jnedbal/garduino_1_0/guarduino.kicad_pcb

## KiCad design guarduino.kicad_pcb (2016-11-27)

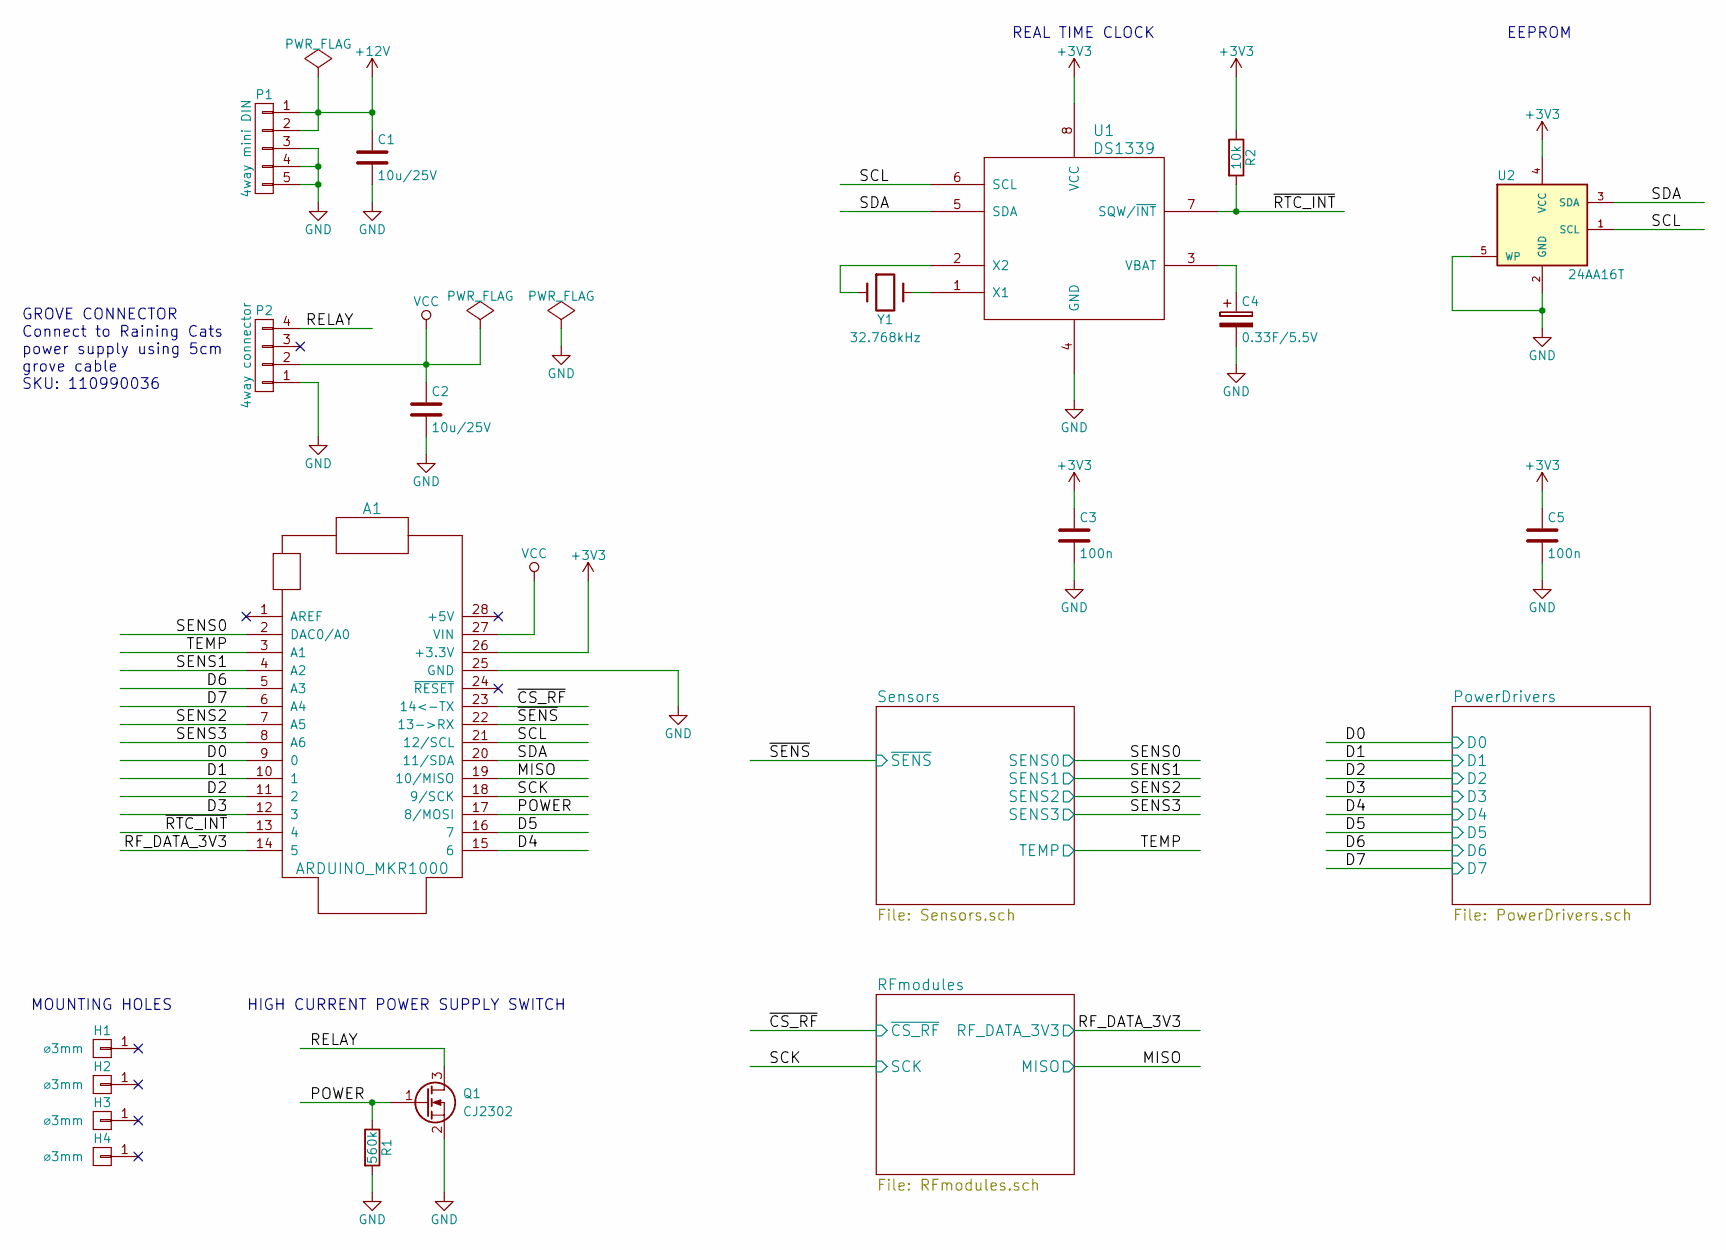
[picture p1: schematic guarduino.sch, Guarduino Control Unit]

Parts:
A1: ARDUINO_MKR1000
C1, C2: 10u/25V; C_0805; Part Number CC0805KKX5R8BB106
C3, C5: 100n; C_0603; Part Number CC0603KRX7R9BB104
C4: 0.33F/5.5V; SD_CAP; Part Number EECS0HD334VN
H1, H2, H3, H4: ⌀3mm; MountingHole_3.2mm_M3
P1: 4way mini DIN; MiniDIN4way; Part Number 2MJ-0402A110
P2: 4way connector; JST_PH_04way_vert; Part Number 1125S-4P
Q1: CJ2302; SOT-23; Part Number CJ2302
R1: 560k; R_0603; Part Number RC0603JR-07560KL
R2: 10k; R_0603; Part Number RC0603FR-0710KL
U1: DS1339; MSOP-8_3x3mm_Pitch0.65mm; Part Number DS1339U-33+T&R
U2: 24AA16T; SOT-23-5; Part Number 24AA16T-I/OT
Y1: 32.768kHz; Crystal_SMD_5032_2Pads; Part Number FC-135

Connections:
+3V3: A1.26 (+3.3V), C3.1, C5.1, R2.1, U1.8 (VCC), U2.4 (VCC); also elsewhere on the board
+12V: C1.1, P1.1, P1.2; also elsewhere on the board
/POWER: A1.17 (8/MOSI), Q1.1 (G), R1.1
/PowerDrivers/D0: A1.9 (0); also elsewhere on the board
/PowerDrivers/D1: A1.10 (1); also elsewhere on the board
/PowerDrivers/D2: A1.11 (2); also elsewhere on the board
/PowerDrivers/D3: A1.12 (3); also elsewhere on the board
/PowerDrivers/D4: A1.15 (6); also elsewhere on the board
/PowerDrivers/D5: A1.16 (7); also elsewhere on the board
/PowerDrivers/D6: A1.5 (A3); also elsewhere on the board
/PowerDrivers/D7: A1.6 (A4); also elsewhere on the board
/RELAY: P2.4, Q1.3 (D)
/RFmodules/MISO: A1.19 (10/MISO); also elsewhere on the board
/RFmodules/RF_DATA_3V3: A1.14 (5); also elsewhere on the board
/RFmodules/SCK: A1.18 (9/SCK); also elsewhere on the board
/RFmodules/~CS_RF: A1.23 (14<-TX); also elsewhere on the board
/SCL: A1.21 (12/SCL), U1.6 (SCL), U2.1 (SCL)
/SDA: A1.20 (11/SDA), U1.5 (SDA), U2.3 (SDA)
/Sensors/SENS0: A1.2 (DAC0/A0); also elsewhere on the board
/Sensors/SENS1: A1.4 (A2); also elsewhere on the board
/Sensors/SENS2: A1.7 (A5); also elsewhere on the board
/Sensors/SENS3: A1.8 (A6); also elsewhere on the board
/Sensors/TEMP: A1.3 (A1); also elsewhere on the board
/Sensors/~SENS: A1.22 (13->RX); also elsewhere on the board
/~RTC_INT: A1.13 (4), R2.2, U1.7 (SQW/~INT)
GND: A1.25 (GND), C1.2, C2.2, C3.2, C4.2, C5.2, P1.3, P1.4, P1.5, P2.1, Q1.2 (S), R1.2, U1.4 (GND), U2.2 (GND), U2.5 (WP); also elsewhere on the board
unnamed: C4.1, U1.3 (VBAT)
unnamed: U1.1 (X1), Y1.2
unnamed: U1.2 (X2), Y1.1
VCC: A1.27 (VIN), C2.1, P2.2; also elsewhere on the board

Notes on the sheet:
GROVE CONNECTOR Connect to Raining Cats power supply using 5cm grove cable SKU: 110990036
REAL TIME CLOCK
EEPROM
MOUNTING HOLES
HIGH CURRENT POWER SUPPLY SWITCH

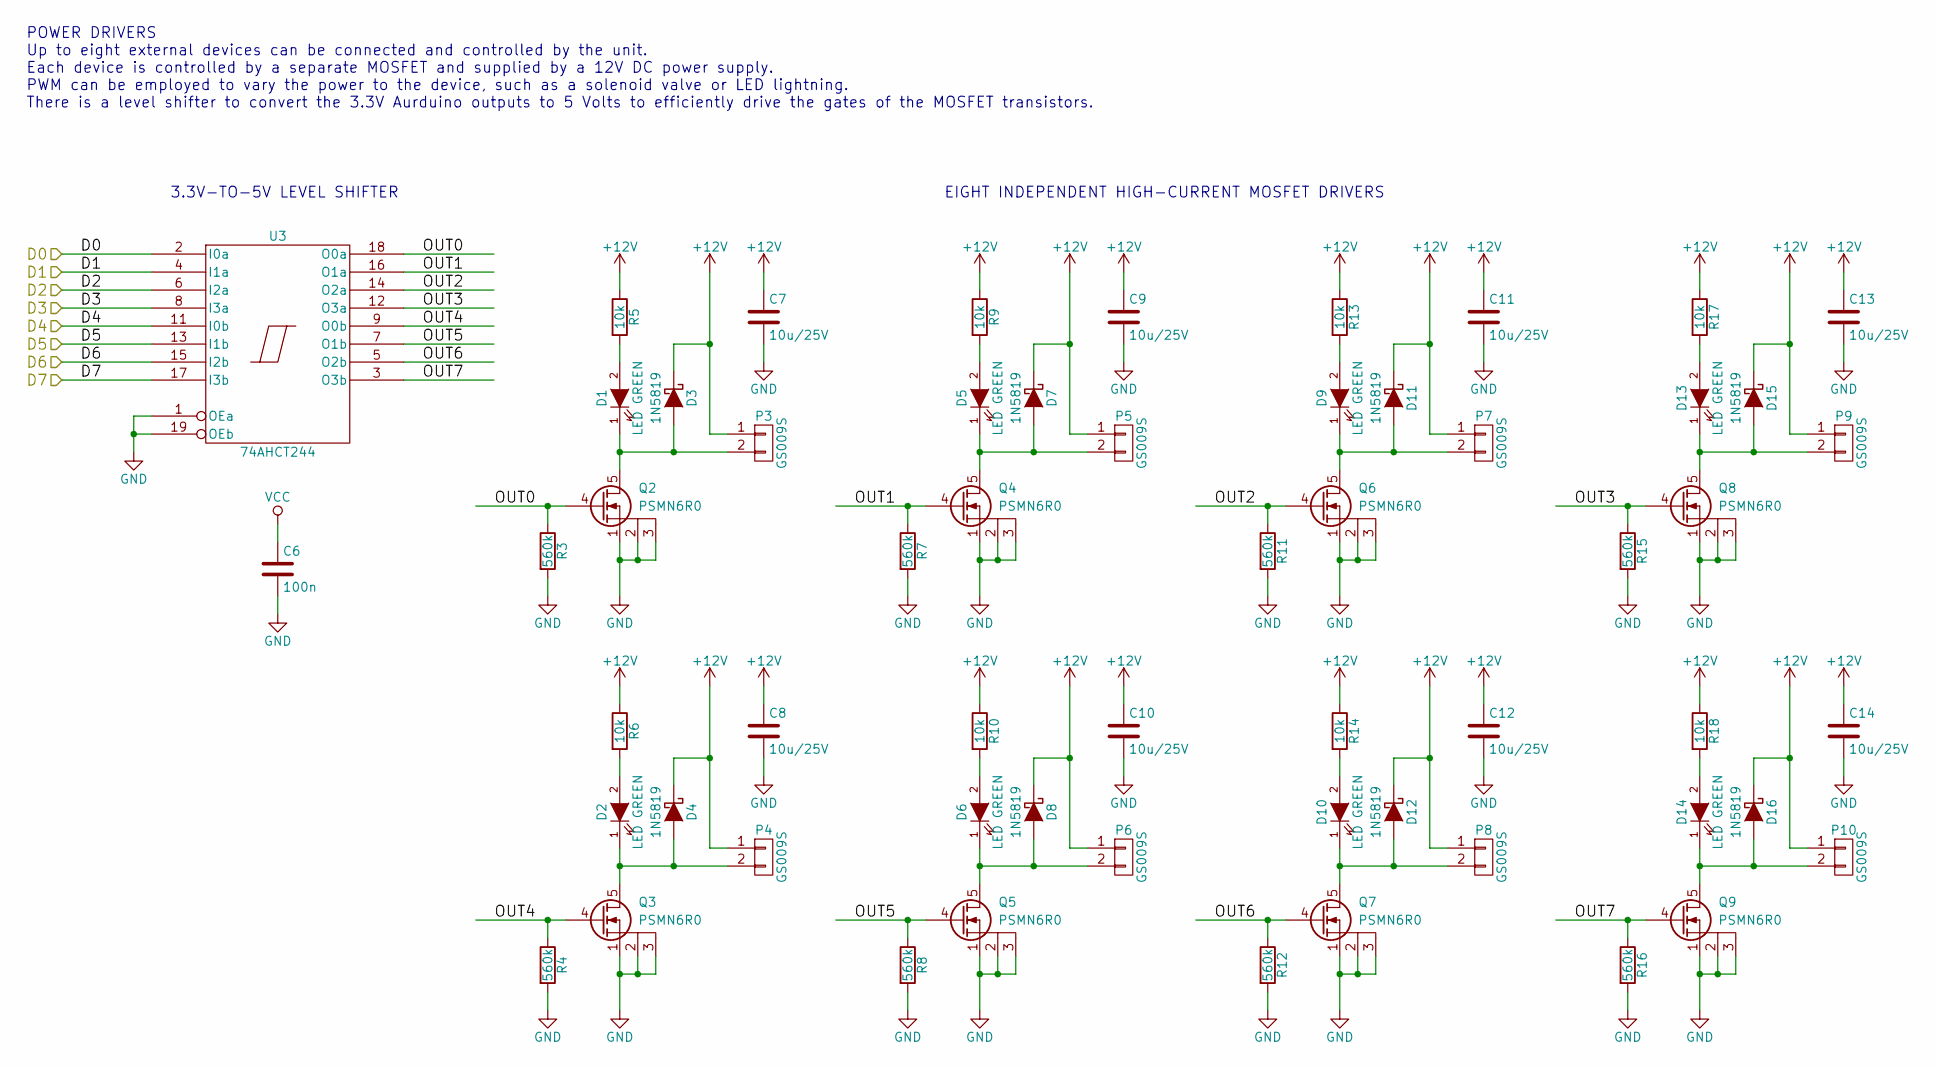
[picture p2: schematic PowerDrivers.sch, Guarduino Control Unit]

Parts:
C6: 100n; C_0603; Part Number CC0603KRX7R9BB104
C7, C8, C9, C10, C11, C12, C13, C14: 10u/25V; C_0805; Part Number CC0805KKX5R8BB106
D1, D2, D5, D6, D9, D10, D13, D14: LED GREEN; LED_0603; Part Number 19-217-G7C-AN1P2-3T
D3, D4, D7, D8, D11, D12, D15, D16: 1N5819; SMA_Standard; Part Number 1N5819HW-7-F
P3, P4, P5, P6, P7, P8, P9, P10: GS009S; AK300-2; Part Number GS009S-5.0-02P-1
Q2, Q3, Q4, Q5, Q6, Q7, Q8, Q9: PSMN6R0; SO-8_PowerPAK_Vishay_Single; Part Number PSMN6R0-30YLB
R3, R4, R7, R8, R11, R12, R15, R16: 560k; R_0603; Part Number RC0603JR-07560KL
R5, R6, R9, R10, R13, R14, R17, R18: 10k; R_0603; Part Number RC0603FR-0710KL
U3: 74AHCT244; TSSOP-20_4.4x6.5mm_Pitch0.65mm; Part Number SN74AHCT244PW

Connections:
+12V: C7.1, C8.1, C9.1, C10.1, C11.1, C12.1, C13.1, C14.1, D3.1 (K), D4.1 (K), D7.1 (K), D8.1 (K), D11.1 (K), D12.1 (K), D15.1 (K), D16.1 (K), P3.1, P4.1, P5.1, P6.1, P7.1, P8.1, P9.1, P10.1, R5.1, R6.1, R9.1, R10.1, R13.1, R14.1, R17.1, R18.1; also elsewhere on the board
/PowerDrivers/D0: U3.2 (I0a); also elsewhere on the board
/PowerDrivers/D1: U3.4 (I1a); also elsewhere on the board
/PowerDrivers/D2: U3.6 (I2a); also elsewhere on the board
/PowerDrivers/D3: U3.8 (I3a); also elsewhere on the board
/PowerDrivers/D4: U3.11 (I0b); also elsewhere on the board
/PowerDrivers/D5: U3.13 (I1b); also elsewhere on the board
/PowerDrivers/D6: U3.15 (I2b); also elsewhere on the board
/PowerDrivers/D7: U3.17 (I3b); also elsewhere on the board
/PowerDrivers/OUT0: Q2.4 (G), R3.1, U3.18 (O0a)
/PowerDrivers/OUT1: Q4.4 (G), R7.1, U3.16 (O1a)
/PowerDrivers/OUT2: Q6.4 (G), R11.1, U3.14 (O2a)
/PowerDrivers/OUT3: Q8.4 (G), R15.1, U3.12 (O3a)
/PowerDrivers/OUT4: Q3.4 (G), R4.1, U3.9 (O0b)
/PowerDrivers/OUT5: Q5.4 (G), R8.1, U3.7 (O1b)
/PowerDrivers/OUT6: Q7.4 (G), R12.1, U3.5 (O2b)
/PowerDrivers/OUT7: Q9.4 (G), R16.1, U3.3 (O3b)
GND: C6.2, C7.2, C8.2, C9.2, C10.2, C11.2, C12.2, C13.2, C14.2, Q2.1 (S), Q2.2 (S), Q2.3 (S), Q3.1 (S), Q3.2 (S), Q3.3 (S), Q4.1 (S), Q4.2 (S), Q4.3 (S), Q5.1 (S), Q5.2 (S), Q5.3 (S), Q6.1 (S), Q6.2 (S), Q6.3 (S), Q7.1 (S), Q7.2 (S), Q7.3 (S), Q8.1 (S), Q8.2 (S), Q8.3 (S), Q9.1 (S), Q9.2 (S), Q9.3 (S), R3.2, R4.2, R7.2, R8.2, R11.2, R12.2, R15.2, R16.2, U3.1 (OEa), U3.10 (GND), U3.19 (OEb); also elsewhere on the board
unnamed: D1.1 (K), D3.2 (A), P3.2, Q2.5 (D)
unnamed: D1.2 (A), R5.2
unnamed: D2.1 (K), D4.2 (A), P4.2, Q3.5 (D)
unnamed: D2.2 (A), R6.2
unnamed: D5.1 (K), D7.2 (A), P5.2, Q4.5 (D)
unnamed: D5.2 (A), R9.2
unnamed: D6.1 (K), D8.2 (A), P6.2, Q5.5 (D)
unnamed: D6.2 (A), R10.2
unnamed: D9.2 (A), R13.2
unnamed: D10.1 (K), D12.2 (A), P8.2, Q7.5 (D)
unnamed: D10.2 (A), R14.2
unnamed: D9.1 (K), D11.2 (A), P7.2, Q6.5 (D)
unnamed: D13.1 (K), D15.2 (A), P9.2, Q8.5 (D)
unnamed: D13.2 (A), R17.2
unnamed: D14.1 (K), D16.2 (A), P10.2, Q9.5 (D)
unnamed: D14.2 (A), R18.2
VCC: C6.1, U3.20 (VCC); also elsewhere on the board

Notes on the sheet:
POWER DRIVERS Up to eight external devices can be connected and controlled by the unit. Each device is controlled by a separate MOSFET and supplied by a 12V DC power supply. PWM can be employed to vary the power to the device, such as a solenoid valve or LED lightning. There is a level shifter to c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
EIGHT INDEPENDENT HIGH-CURRENT MOSFET DRIVERS
3.3V-TO-5V LEVEL SHIFTER

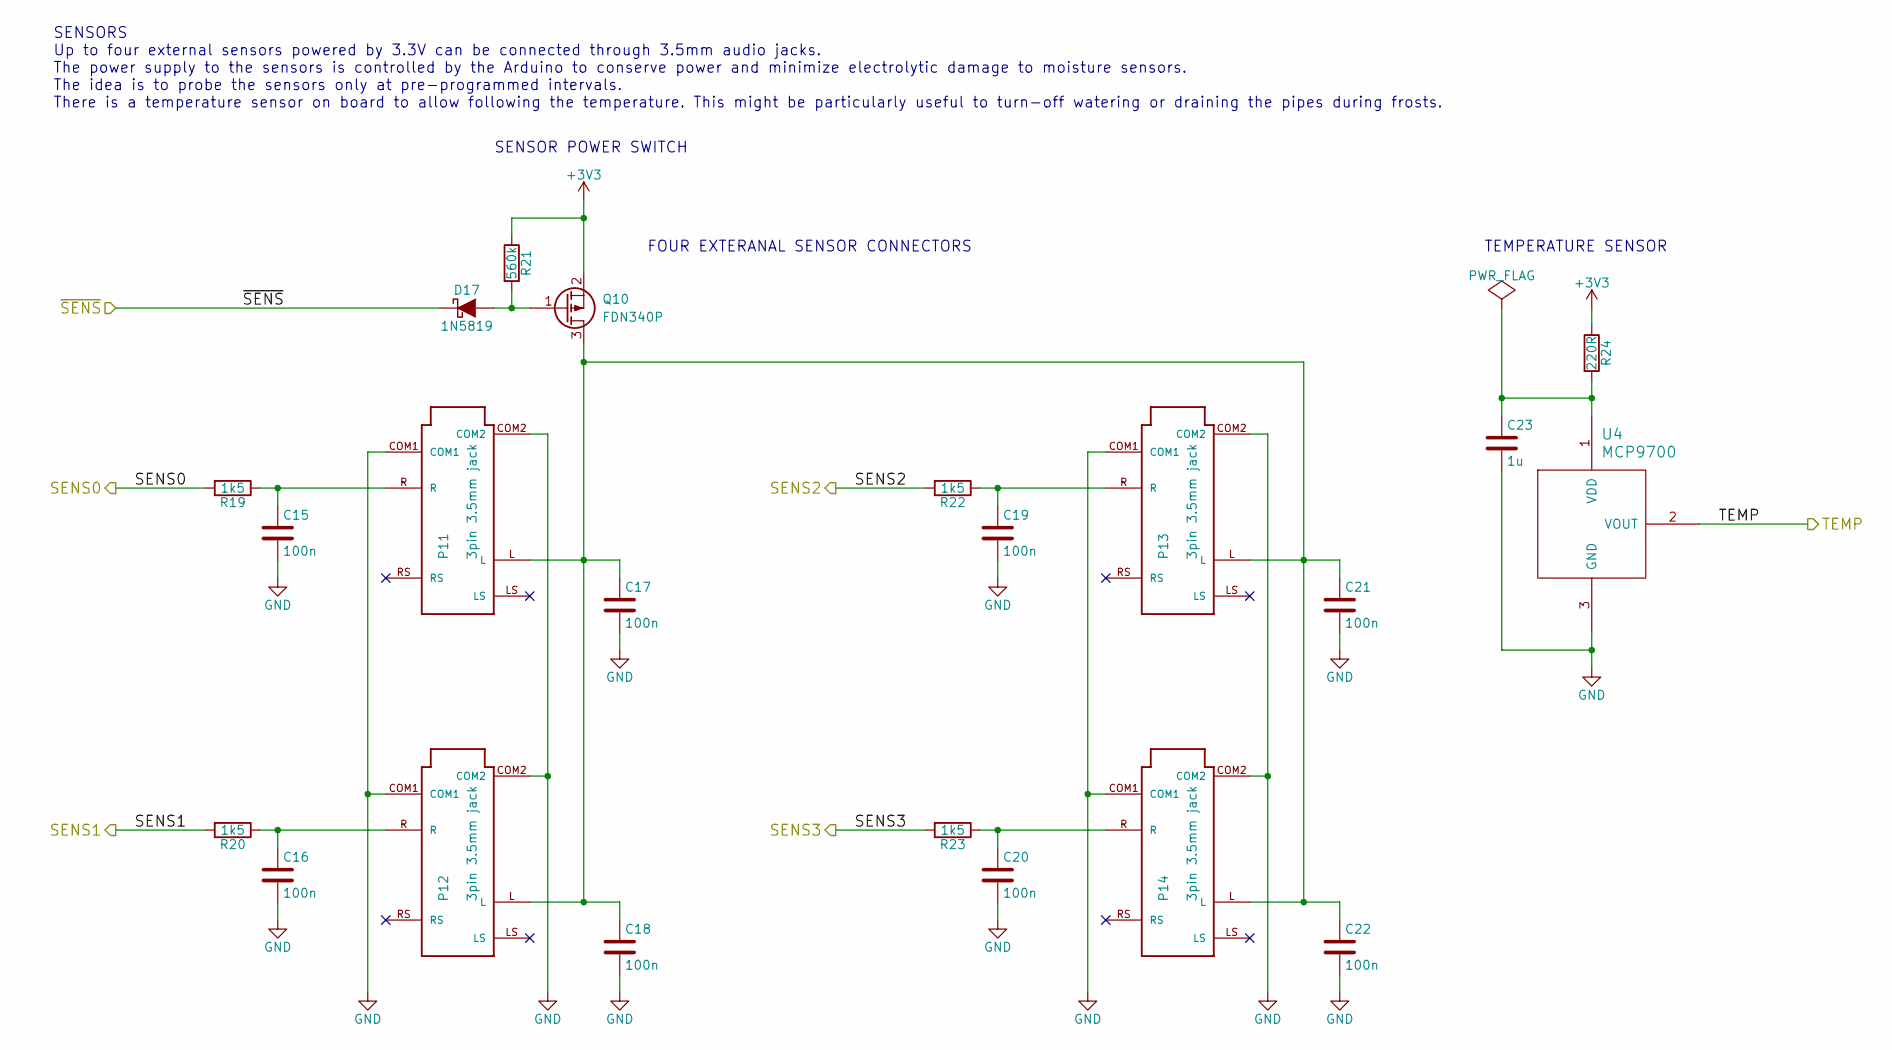
[picture p3: schematic Sensors.sch, Guarduino Control Unit]

Parts:
C15, C16, C17, C18, C19, C20, C21, C22: 100n; C_0603; Part Number CC0603KRX7R9BB104
C23: 1u; C_0603; Part Number CC0603KRX7R8BB105
D17: 1N5819; SMA_Standard; Part Number 1N5819HW-7-F
P11, P12, P13, P14: 3pin 3.5mm jack; SUNTECH_ST-PJ-312; Part Number ST-PJ-312
Q10: FDN340P; SOT-23; Part Number FDN340P
R19, R20, R22, R23: 1k5; R_0603; Part Number RC0603JR-071K5L
R21: 560k; R_0603; Part Number RC0603JR-07560KL
R24: 220R; R_0603; Part Number RC0603JR-07220RL
U4: MCP9700; SOT-23; Part Number MCP9700AT-E/TT

Connections:
+3V3: Q10.2 (S), R21.1, R24.1; also elsewhere on the board
/Sensors/SENS0: R19.2; also elsewhere on the board
/Sensors/SENS1: R20.2; also elsewhere on the board
/Sensors/SENS2: R22.2; also elsewhere on the board
/Sensors/SENS3: R23.2; also elsewhere on the board
/Sensors/TEMP: U4.2 (VOUT); also elsewhere on the board
/Sensors/~SENS: D17.1 (K); also elsewhere on the board
GND: C15.2, C16.2, C17.2, C18.2, C19.2, C20.2, C21.2, C22.2, C23.2, P11.COM1, P11.COM2, P12.COM1, P12.COM2, P13.COM1, P13.COM2, P14.COM1, P14.COM2, U4.3 (GND); also elsewhere on the board
unnamed: C15.1, P11.R, R19.1
unnamed: C16.1, P12.R, R20.1
unnamed: C17.1, C18.1, C21.1, C22.1, P11.L, P12.L, P13.L, P14.L, Q10.3 (D)
unnamed: C19.1, P13.R, R22.1
unnamed: C20.1, P14.R, R23.1
unnamed: C23.1, R24.2, U4.1 (VDD)
unnamed: D17.2 (A), Q10.1 (G), R21.2

Notes on the sheet:
SENSORS Up to four external sensors powered by 3.3V can be connected through 3.5mm audio jacks. The power supply to the sensors is controlled by the Arduino to conserve power and minimize electrolytic damage to moisture sensors. The idea is to probe the sensors only at pre-programmed intervals. The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
SENSOR POWER SWITCH
FOUR EXTERANAL SENSOR CONNECTORS
TEMPERATURE SENSOR

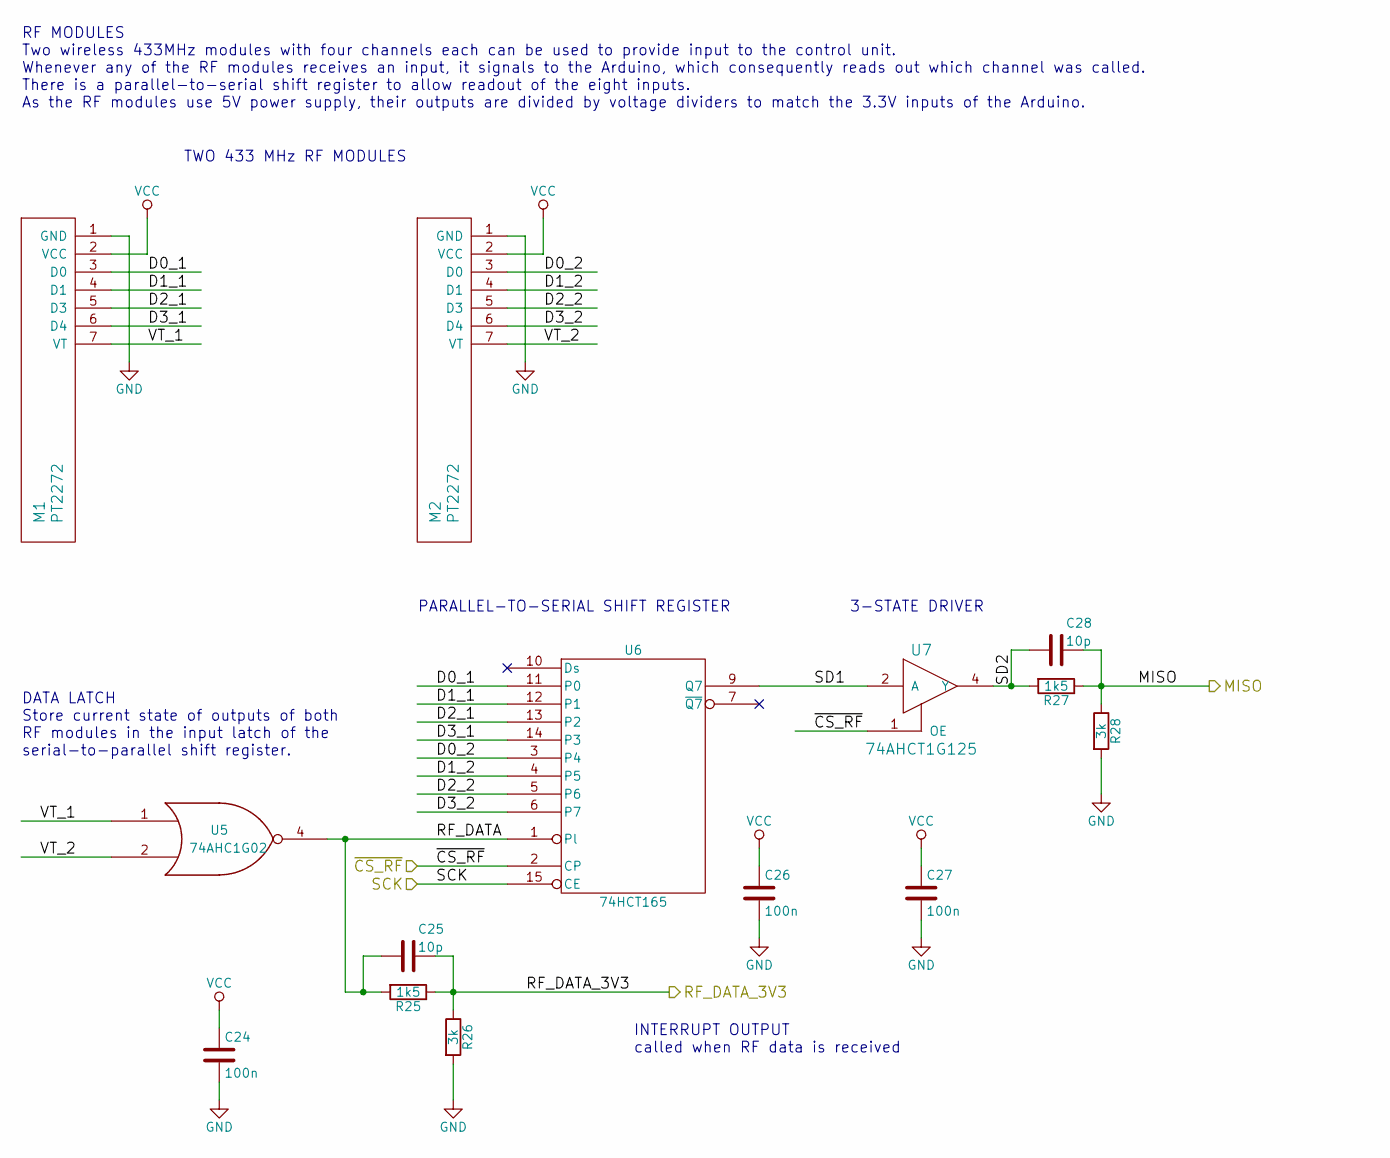
[picture p4: schematic RFmodules.sch, Guarduino Control Unit]

Parts:
C24, C26, C27: 100n; C_0603; Part Number CC0603KRX7R9BB104
C25, C28: 10p; C_0603; Part Number CC0603JRNPO9BN100
M1, M2: PT2272; Socket_Strip_Straight_1x07
R25, R27: 1k5; R_0603; Part Number RC0603JR-071K5L
R26, R28: 3k; R_0603; Part Number RC0603FR-073KL
U5: 74AHC1G02; SC-70-5; Part Number SN74AHC1G02DCKR
U6: 74HCT165; SOIC-16_3.9x9.9mm_Pitch1.27mm; Part Number CD74HCT165M96
U7: 74AHCT1G125; SC-70-5; Part Number SN74AHCT1G125DCKT

Connections:
/RFmodules/D0_1: M1.3 (D0), U6.11 (P0)
/RFmodules/D0_2: M2.3 (D0), U6.3 (P4)
/RFmodules/D1_1: M1.4 (D1), U6.12 (P1)
/RFmodules/D1_2: M2.4 (D1), U6.4 (P5)
/RFmodules/D2_1: M1.5 (D3), U6.13 (P2)
/RFmodules/D2_2: M2.5 (D3), U6.5 (P6)
/RFmodules/D3_1: M1.6 (D4), U6.14 (P3)
/RFmodules/D3_2: M2.6 (D4), U6.6 (P7)
/RFmodules/MISO: C28.1, R27.1, R28.1; also elsewhere on the board
/RFmodules/RF_DATA: C25.2, R25.2, U5.4, U6.1 (Pl)
/RFmodules/RF_DATA_3V3: C25.1, R25.1, R26.1; also elsewhere on the board
/RFmodules/SCK: U6.15 (CE); also elsewhere on the board
/RFmodules/SD1: U6.9 (Q7), U7.2 (A)
/RFmodules/SD2: C28.2, R27.2, U7.4 (Y)
/RFmodules/VT_1: M1.7 (VT), U5.1
/RFmodules/VT_2: M2.7 (VT), U5.2
/RFmodules/~CS_RF: U6.2 (CP), U7.1 (OE); also elsewhere on the board
GND: C24.2, C26.2, C27.2, M1.1 (GND), M2.1 (GND), R26.2, R28.2, U5.3 (GND), U6.8 (GND), U7.3 (GND); also elsewhere on the board
VCC: C24.1, C26.1, C27.1, M1.2 (VCC), M2.2 (VCC), U5.5 (VCC), U6.16 (VCC), U7.5 (VCC); also elsewhere on the board

Notes on the sheet:
RF MODULES Two wireless 433MHz modules with four channels each can be used to provide input to the control unit. Whenever any of the RF modules receives an input, it signals to the Arduino, which consequently reads out which channel was called. There is a parallel-to-serial shift register to allow 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
TWO 433 MHz RF MODULES
DATA LATCH Store current state of outputs of both RF modules in the input latch of the serial-to-parallel shift register.
PARALLEL-TO-SERIAL SHIFT REGISTER
INTERRUPT OUTPUT called when RF data is received
3-STATE DRIVER

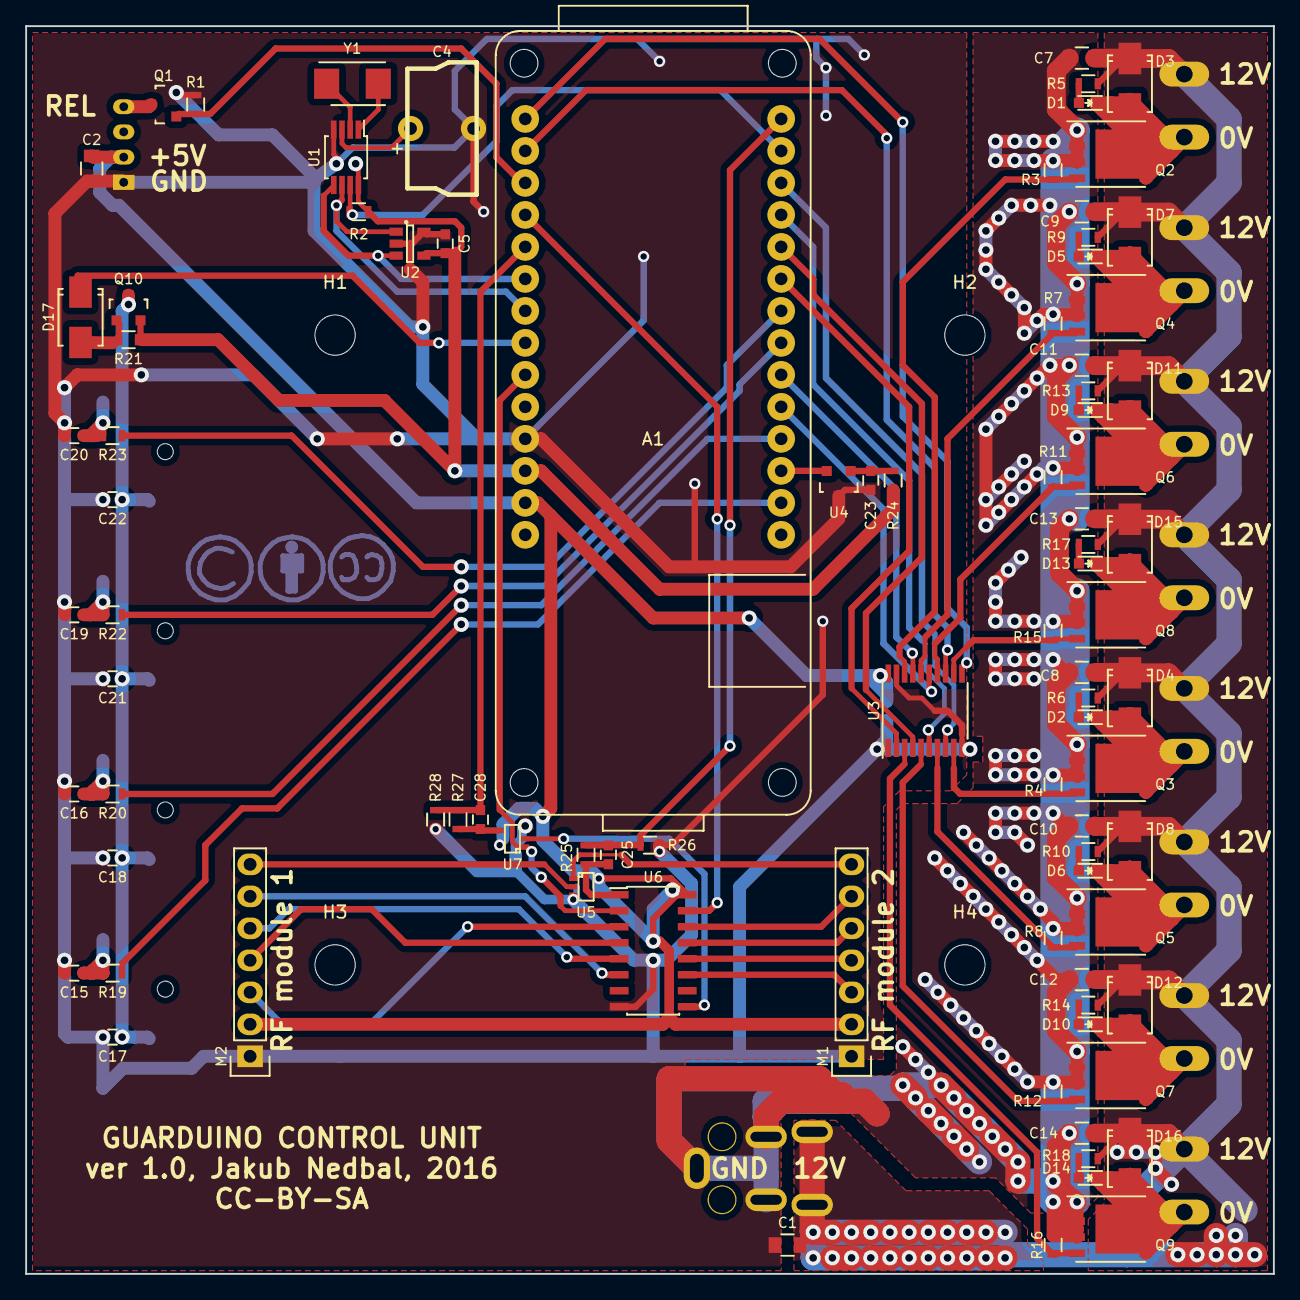
[picture p5: board guarduino.kicad_pcb from above]

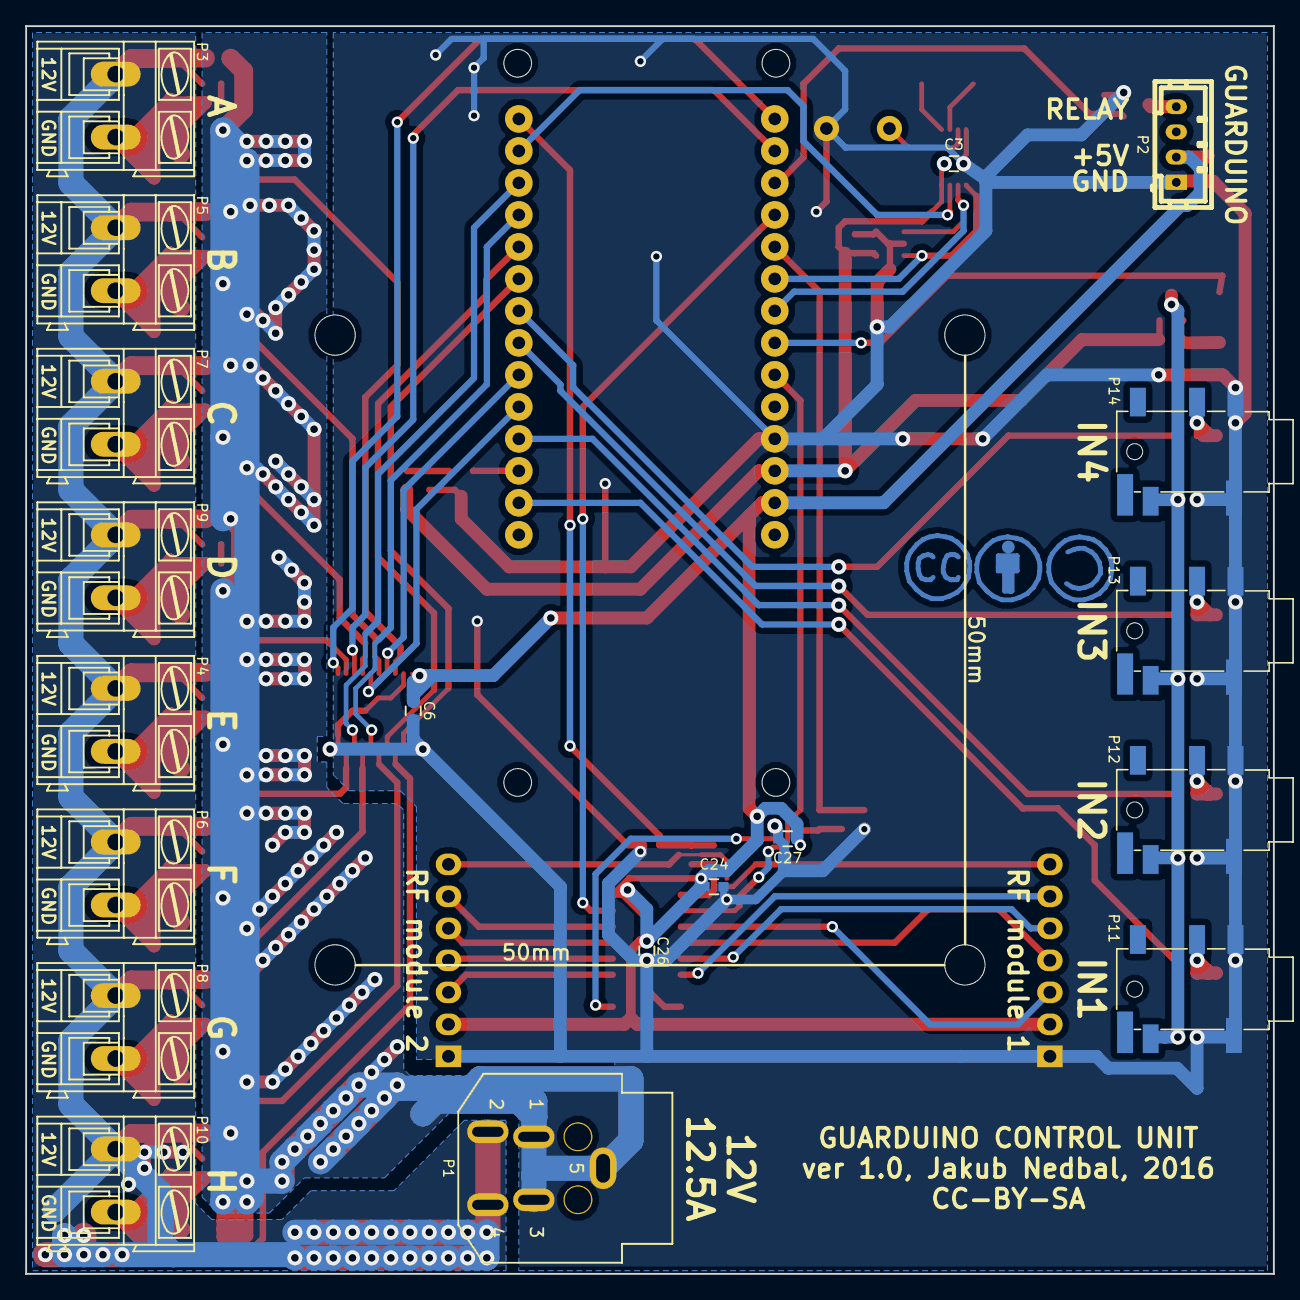
[picture p6: board guarduino.kicad_pcb from below]

Board: 2 copper layers, 99.1 x 99.1 mm, 112 parts (19 on the bottom side), 74 nets.
