jnedbal/garduino_1_0/(commit log)

2016-06-22 Finished schematics
    [PowerDrivers.sch, RFmodules.sch, Sensors.sch, garduino.csv, garduino.kicad_pcb, garduino.sch]
2016-06-26 Laid out parts and routed some of the signals
    [PowerDrivers.sch, garduino.kicad_pcb, garduino.sch]
2016-10-07 Final production board
    [PowerDrivers.sch, RFmodules.sch, Sensors.sch, garduino.csv, garduino.kicad_pcb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]
2016-10-07 Fixed order codes
    [RFmodules.sch, guarduino.csv, guarduino.sch, guarduino_Seeed.csv]
2016-11-27 Flipped C6 onto the bottom layer so it doesn't clash with U3
    [guarduino-B.Cu.gbl, guarduino-B.Mask.gbs, guarduino-B.SilkS.gbo, guarduino-Edge.Cuts.gm1, guarduino-F.Cu.gtl, guarduino-F.Mask.gts, guarduino-F.SilkS.gto, guarduino.drl]
