jnedbal/garduino_1_0/(notices)

Notices in the files:
RFmodules.sch:
License: CC-BY-SA
guarduino.kicad_pcb:
CC-BY-SA
